nils-eilers/PROXA-Printer-Interface/hardware/Original-schematics-A.jpg

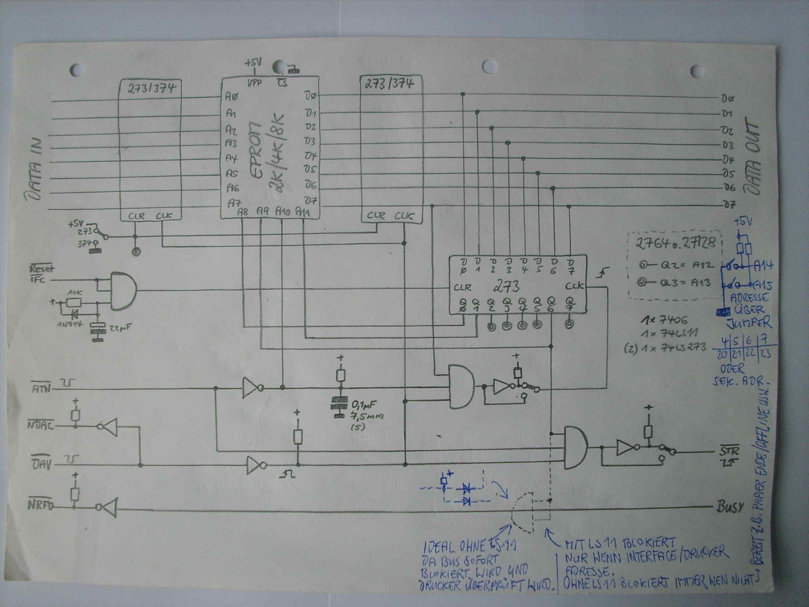
hardware/Original-schematics-A.jpg
