nils-eilers/PROXA-Printer-Interface/hardware/Printer-Interface-assembled.jpg

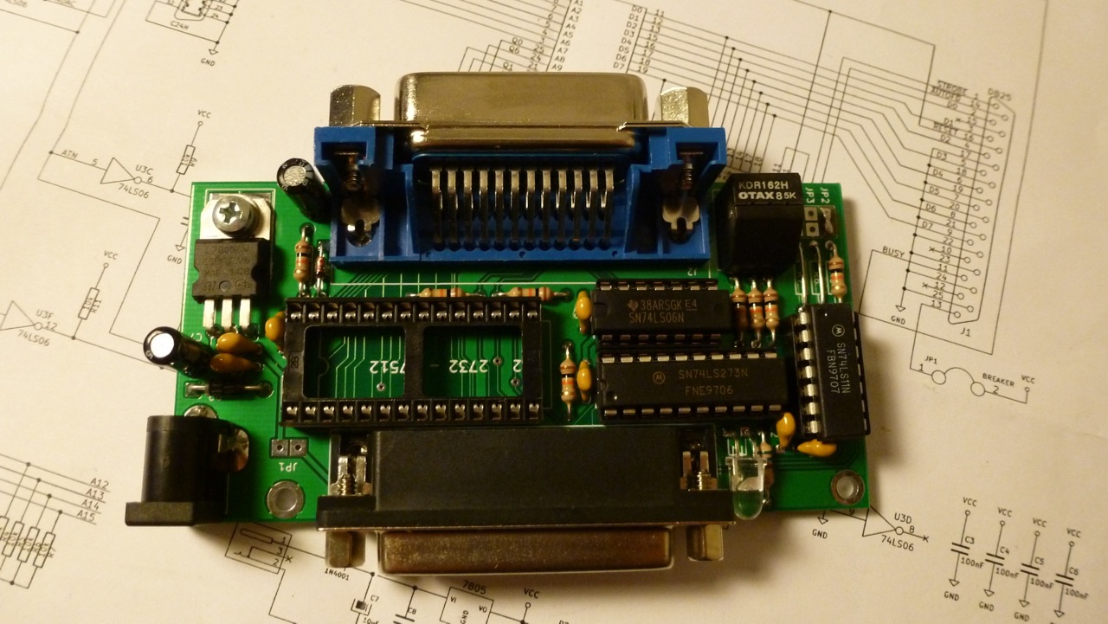
hardware/Printer-Interface-assembled.jpg
