nils-eilers/PROXA-Printer-Interface/hardware/Original-schematics-B.jpg

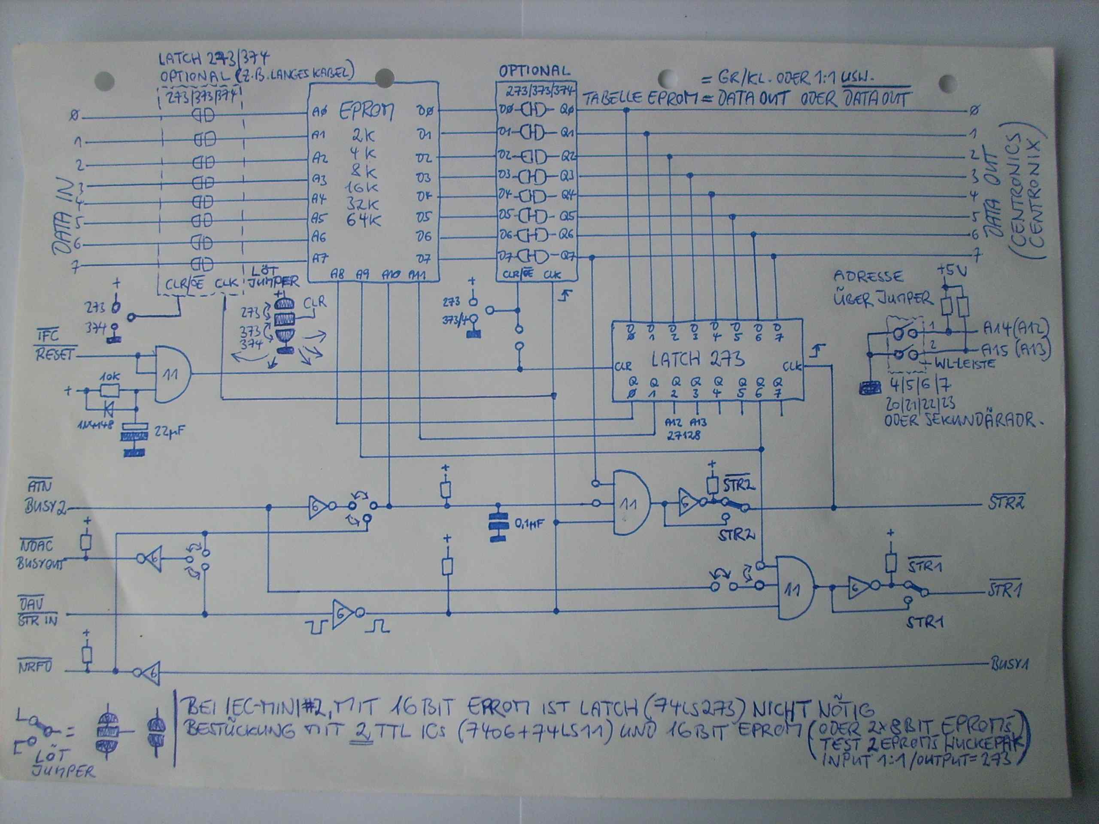
hardware/Original-schematics-B.jpg
