nils-eilers/PROXA-Printer-Interface/hardware/schematics.pdf

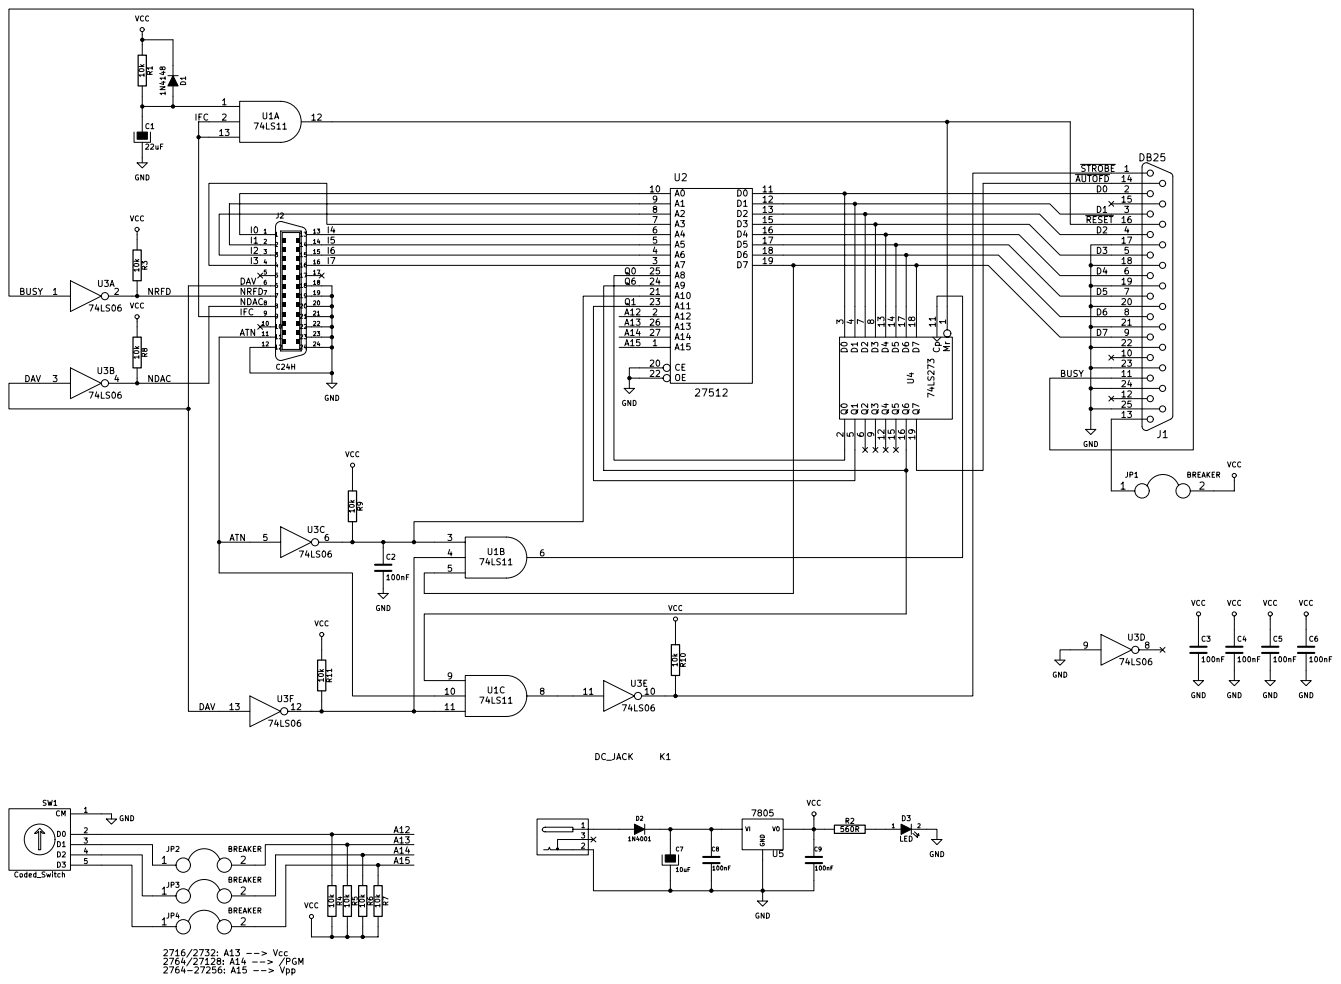
[picture p4: page 1]
