nils-eilers/PROXA-Printer-Interface/hardware/KiCAD/Proxa-Printer-Interface.kicad_pcb

## KiCad design hardware/KiCAD/Proxa-Printer-Interface.kicad_pcb (2019-11-12)

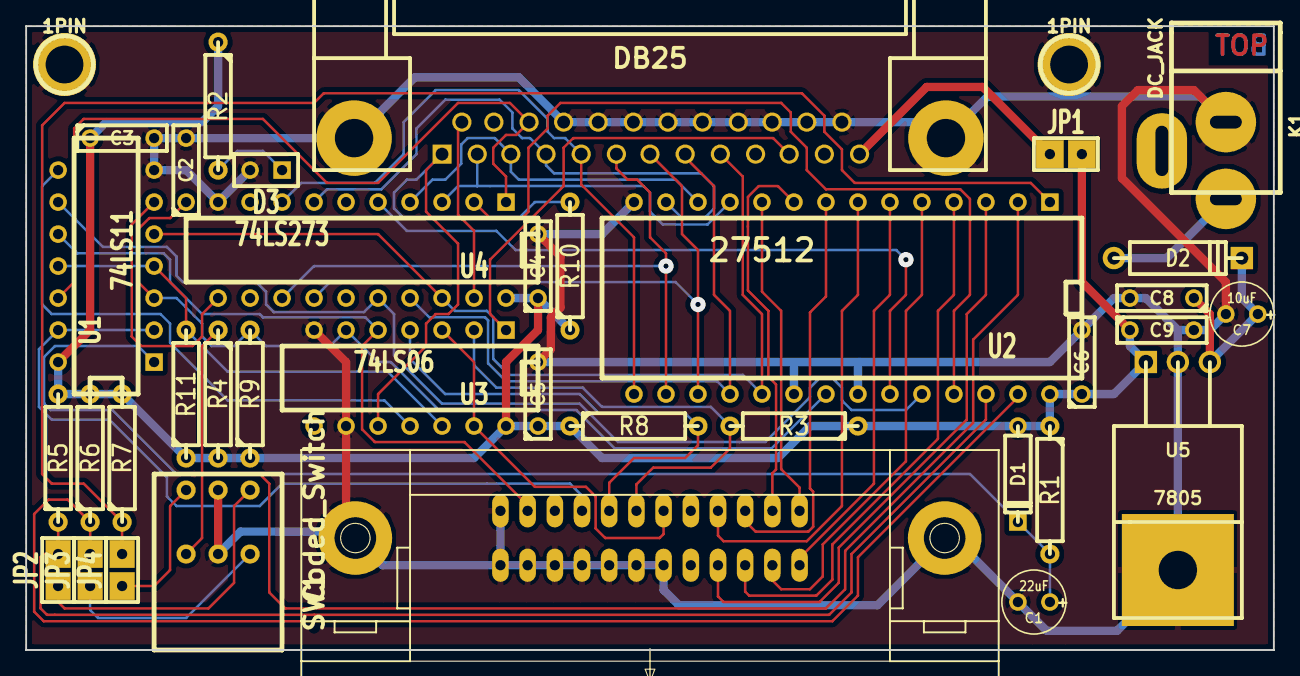
[picture p5: board Proxa-Printer-Interface.kicad_pcb from above]

Board: 2 copper layers, 99.1 x 49.5 mm, 38 parts (0 on the bottom side), 46 nets.

Parts:
1PIN, 1PIN#2: P***; 1pin
C1: 22uF; C1V5
C2, C3, C4, C5, C6, C8, C9: 100nF; C2
C7: 10uF; C1V5
D1: 1N4148; D3
D2: 1N4001; D4
D3: LED; SIL-2
J1: DB25; DB25FC
J2: C24H; con-amp-champ-24HP
JP1, JP2, JP3, JP4: BREAKER; SIL-2
K1: DC_JACK; JACK_ALIM
R1, R3, R4, R5, R6, R7, R8, R9, R10, R11: 10k; R4
R2: 560R; R4
SW1: Coded_Switch; ENCSW
U1: 74LS11; DIP-14__300
U2: 27512; DIP-28__600
U3: 74LS06; DIP-14__300
U4: 74LS273; DIP-20__300
U5: 7805; TO220

Connections:
/A12: R4.1, SW1.2, U2.2
/A13: JP2.2, R5.1, U2.26
/A14: JP3.2, R6.1, U2.27
/A15: JP4.2, R7.1, U2.1
/ATN: J2.11, U1.10, U3.5
/BUSY: J1.11, U3.1
/D0: J1.2, U2.11, U4.3
/D1: J1.3, U2.12, U4.4
/D2: J1.4, U2.13, U4.7
/D3: J1.5, U2.15, U4.8
/D4: J1.6, U2.16, U4.13
/D5: J1.7, U2.17, U4.14
/D6: J1.8, U2.18, U4.17
/D7: J1.9, U1.5, U2.19, U4.18
/DAV: J2.6, U3.3, U3.13
/I0: J2.1, U2.10
/I1: J2.2, U2.9
/I2: J2.3, U2.8
/I3: J2.4, U2.7
/I4: J2.13, U2.6
/I5: J2.14, U2.5
/I6: J2.15, U2.4
/I7: J2.16, U2.3
/IFC: J2.9, U1.2, U1.13
/NDAC: J2.8, R8.2, U3.4
/NRFD: J2.7, R3.2, U3.2
/Q0: U2.25, U4.2
/Q1: U2.23, U4.5
/Q6: U1.9, U2.24, U4.16
/~AUTOFD: J1.14, U4.19
/~RESET: J1.16, U1.12, U4.1
/~STROBE: J1.1, R10.2, U3.10
GND: 1PIN.1, 1PIN#2.1, C1.2, C2.2, C3.2, C4.2, C5.2, C6.2, C7.2, C8.2, C9.2, D3.2, J1.17, J1.18, J1.19, J1.20, J1.21, J1.22, J1.23, J1.24, J1.25, J2.12, J2.18, J2.19, J2.20, J2.21, J2.22, J2.23, J2.24, K1.2, SW1.1, U1.7, U2.14, U2.20, U2.22, U3.7, U3.9, U4.10, U5.2, U5.4
unnamed: U1.8, U3.11
unnamed: JP4.1, SW1.5
unnamed: J1.13, JP1.1
unnamed: D3.1, R2.2
unnamed: JP2.1, SW1.3
unnamed: JP3.1, SW1.4
unnamed: D2.1, K1.1
unnamed: C7.1, C8.1, D2.2, U5.3
unnamed: C2.1, R9.2, U1.3, U2.21, U3.6
unnamed: R11.2, U1.4, U1.11, U3.12
unnamed: U1.6, U4.11
unnamed: C1.1, D1.2, R1.2, U1.1
VCC: C3.1, C4.1, C5.1, C6.1, C9.1, D1.1, JP1.2, R1.1, R2.1, R3.1, R4.2, R5.2, R6.2, R7.2, R8.1, R9.1, R10.1, R11.1, U1.14, U2.28, U3.14, U4.20, U5.1
